essensys-hub/essensys-i2c-etoile-0v/export/n2-etoile-0v-pcb-bottom.png

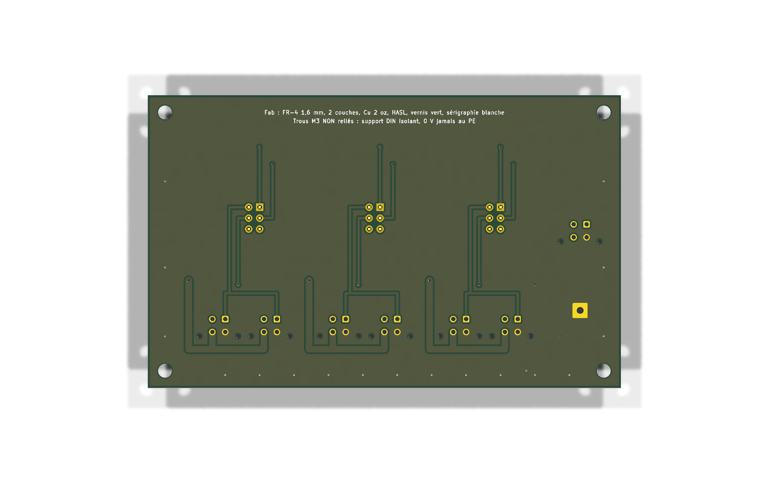
export/n2-etoile-0v-pcb-bottom.png
