essensys-hub/essensys-i2c-etoile-0v/export/n2-etoile-0v-bom.csv

Repère | Valeur | Empreinte | Fabricant | Référence | Qté
D1-D3 | SMAJ16A | Diode_SMD:D_SMA | Littelfuse | SMAJ16A | 3
F1-F3 | PTC >=30 V 1812 | Fuse:Fuse_1812_4532Metric | Littelfuse | 1812L050/30MR (à confirmer : Ihold@50°C >= 1,5 x I BA_ALIM) | 3
J1 | BP J31 (WR-MPC3 2x2) | Connector_Molex:Molex_Micro-Fit_3.0_43045-0412_2x02_P3.00mm_Vertical | Würth Elektronik | 66200421122 (WR-MPC3 2x2, vertical, THT) | 1
J2 | BA1 J1 (WR-MPC3 2x2) | Connector_Molex:Molex_Micro-Fit_3.0_43045-0412_2x02_P3.00mm_Vertical | Würth Elektronik | 66200421122 (WR-MPC3 2x2, vertical, THT) | 1
J3 | BA1 J2 (WR-MPC3 2x2) | Connector_Molex:Molex_Micro-Fit_3.0_43045-0412_2x02_P3.00mm_Vertical | Würth Elektronik | 66200421122 (WR-MPC3 2x2, vertical, THT) | 1
J4 | BA2 J1 (WR-MPC3 2x2) | Connector_Molex:Molex_Micro-Fit_3.0_43045-0412_2x02_P3.00mm_Vertical | Würth Elektronik | 66200421122 (WR-MPC3 2x2, vertical, THT) | 1
J5 | BA2 J2 (WR-MPC3 2x2) | Connector_Molex:Molex_Micro-Fit_3.0_43045-0412_2x02_P3.00mm_Vertical | Würth Elektronik | 66200421122 (WR-MPC3 2x2, vertical, THT) | 1
J6 | BA3 J1 (WR-MPC3 2x2) | Connector_Molex:Molex_Micro-Fit_3.0_43045-0412_2x02_P3.00mm_Vertical | Würth Elektronik | 66200421122 (WR-MPC3 2x2, vertical, THT) | 1
J7 | BA3 J2 (WR-MPC3 2x2) | Connector_Molex:Molex_Micro-Fit_3.0_43045-0412_2x02_P3.00mm_Vertical | Würth Elektronik | 66200421122 (WR-MPC3 2x2, vertical, THT) | 1
JP1 | Cavalier port BA1 (3 shunts) | Connector_PinHeader_2.54mm:PinHeader_2x03_P2.54mm_Vertical |  |  | 1
JP2 | Cavalier port BA2 (3 shunts) | Connector_PinHeader_2.54mm:PinHeader_2x03_P2.54mm_Vertical |  |  | 1
JP3 | Cavalier port BA3 (3 shunts) | Connector_PinHeader_2.54mm:PinHeader_2x03_P2.54mm_Vertical |  |  | 1
