essensys-hub/essensys-i2c-etoile-0v/firmware/test/traces/t04_ba3_absent_nack.csv

# 3 tentatives vers 0x13 absent (NACK adresse) | 100 ms
t_us | scl | sda
0 | 1 | 1
55 | 1 | 0
60 | 0 | 0
70 | 1 | 0
80 | 0 | 0
90 | 1 | 0
100 | 0 | 0
102 | 0 | 1
110 | 1 | 1
120 | 0 | 1
122 | 0 | 0
130 | 1 | 0
140 | 0 | 0
150 | 1 | 0
160 | 0 | 0
162 | 0 | 1
170 | 1 | 1
180 | 0 | 1
190 | 1 | 1
200 | 0 | 1
202 | 0 | 0
210 | 1 | 0
220 | 0 | 0
222 | 0 | 1
230 | 1 | 1
240 | 0 | 1
242 | 0 | 0
250 | 1 | 0
255 | 1 | 1
100260 | 1 | 0
100265 | 0 | 0
100275 | 1 | 0
100285 | 0 | 0
100295 | 1 | 0
100305 | 0 | 0
100307 | 0 | 1
100315 | 1 | 1
100325 | 0 | 1
100327 | 0 | 0
100335 | 1 | 0
100345 | 0 | 0
100355 | 1 | 0
100365 | 0 | 0
100367 | 0 | 1
100375 | 1 | 1
100385 | 0 | 1
100395 | 1 | 1
100405 | 0 | 1
100407 | 0 | 0
100415 | 1 | 0
100425 | 0 | 0
100427 | 0 | 1
100435 | 1 | 1
100445 | 0 | 1
100447 | 0 | 0
100455 | 1 | 0
100460 | 1 | 1
200465 | 1 | 0
200470 | 0 | 0
200480 | 1 | 0
200490 | 0 | 0
200500 | 1 | 0
200510 | 0 | 0
200512 | 0 | 1
200520 | 1 | 1
200530 | 0 | 1
200532 | 0 | 0
200540 | 1 | 0
200550 | 0 | 0
200560 | 1 | 0
200570 | 0 | 0
200572 | 0 | 1
200580 | 1 | 1
200590 | 0 | 1
200600 | 1 | 1
200610 | 0 | 1
200612 | 0 | 0
200620 | 1 | 0
200630 | 0 | 0
200632 | 0 | 1
200640 | 1 | 1
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
