essensys-hub/essensys-i2c-etoile-0v/firmware/test/traces/t06_response_crc_error.csv

# TPS_ACTION vers 0x12 | CRC de reponse faux
t_us | scl | sda
0 | 1 | 1
55 | 1 | 0
60 | 0 | 0
70 | 1 | 0
80 | 0 | 0
90 | 1 | 0
100 | 0 | 0
102 | 0 | 1
110 | 1 | 1
120 | 0 | 1
122 | 0 | 0
130 | 1 | 0
140 | 0 | 0
150 | 1 | 0
160 | 0 | 0
162 | 0 | 1
170 | 1 | 1
180 | 0 | 1
182 | 0 | 0
190 | 1 | 0
200 | 0 | 0
210 | 1 | 0
220 | 0 | 0
230 | 1 | 0
240 | 0 | 0
250 | 1 | 0
260 | 0 | 0
270 | 1 | 0
280 | 0 | 0
290 | 1 | 0
300 | 0 | 0
310 | 1 | 0
320 | 0 | 0
330 | 1 | 0
340 | 0 | 0
342 | 0 | 1
350 | 1 | 1
360 | 0 | 1
362 | 0 | 0
370 | 1 | 0
380 | 0 | 0
390 | 1 | 0
400 | 0 | 0
410 | 1 | 0
420 | 0 | 0
430 | 1 | 0
440 | 0 | 0
450 | 1 | 0
460 | 0 | 0
470 | 1 | 0
480 | 0 | 0
490 | 1 | 0
500 | 0 | 0
502 | 0 | 1
510 | 1 | 1
520 | 0 | 1
522 | 0 | 0
530 | 1 | 0
540 | 0 | 0
542 | 0 | 1
550 | 1 | 1
560 | 0 | 1
562 | 0 | 0
570 | 1 | 0
580 | 0 | 0
590 | 1 | 0
600 | 0 | 0
610 | 1 | 0
620 | 0 | 0
630 | 1 | 0
640 | 0 | 0
650 | 1 | 0
660 | 0 | 0
662 | 0 | 1
670 | 1 | 1
680 | 0 | 1
682 | 0 | 0
690 | 1 | 0
700 | 0 | 0
702 | 0 | 1
710 | 1 | 1
720 | 0 | 1
722 | 0 | 0
730 | 1 | 0
740 | 0 | 0
750 | 1 | 0
760 | 0 | 0
770 | 1 | 0
780 | 0 | 0
790 | 1 | 0
800 | 0 | 0
810 | 1 | 0
820 | 0 | 0
830 | 1 | 0
840 | 0 | 0
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
