essensys-hub/essensys-i2c-etoile-0v/export/n2-etoile-0v-schema.pdf

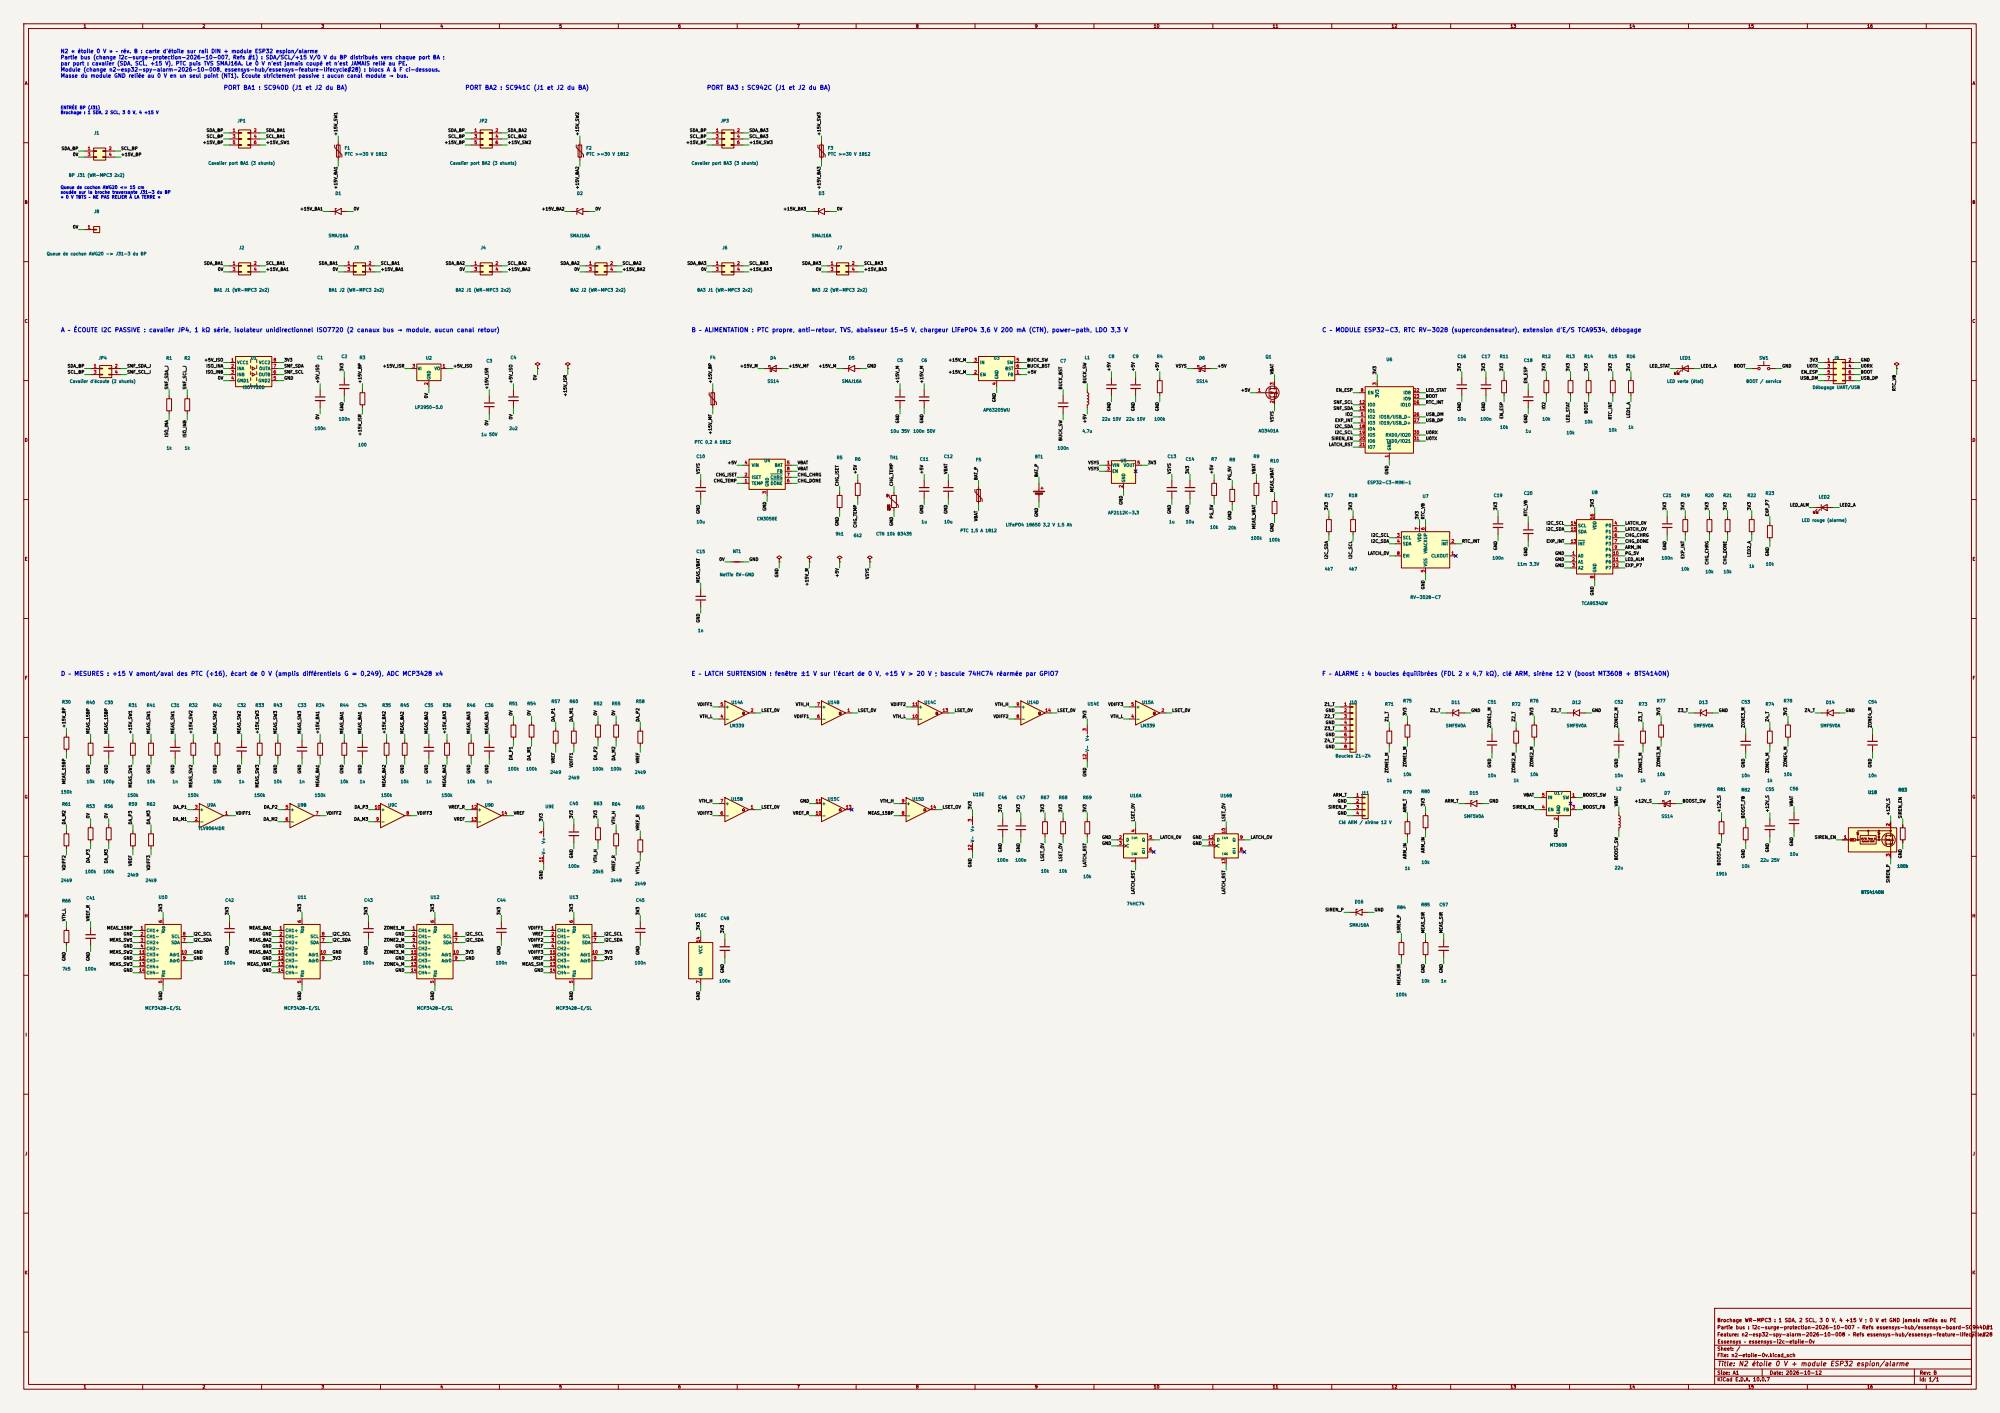
[picture p3: page 1]

N2 « étoile 0 V » – rév. B : carte d'étoile sur rail DIN + module ESP32 espion/alarme
Partie bus (change i2c-surge-protection-2026-10-007, Refs #1) : SDA/SCL/+15 V/0 V du BP distribués vers chaque port BA ; par port : cavalier (SDA, SCL, +15 V), PTC puis TVS SMAJ16A. Le 0 V n'est jamais coupé et n'est JAMAIS relié au PE.
Module (change n2-esp32-spy-alarm-2026-10-008, essensys-hub/essensys-feature-lifecycle#28) : blocs A à F ci-dessous.
Masse du module GND reliée au 0 V en un seul point (NT1). Écoute strictement passive : aucun canal module → bus.

PORT BA3 : SC942C (J1 et J2 du BA)

ENTRÉE BP (J31)
Brochage : 1 SDA, 2 SCL, 3 0 V, 4 +15 V Queue de cochon AWG20 <= 15 cm

soudée sur la broche traversante J31-3 du BP
« 0 V TBTS – NE PAS RELIER À LA TERRE »

A – ÉCOUTE I2C PASSIVE : cavalier JP4, 1 kΩ série, isolateur unidirectionnel ISO7720 (2 canaux bus → module, aucun canal retour)

C – MODULE ESP32-C3, RTC RV-3028 (supercondensateur), extension d'E/S TCA9534, débogage

F – ALARME : 4 boucles équilibrées (FDL 2 x 4,7 kΩ), clé ARM, sirène 12 V (boost MT3608 + BTS4140N)

Brochage WR-MPC3 : 1 SDA, 2 SCL, 3 0 V, 4 +15 V ; 0 V et GND jamais reliés au PE
Partie bus : i2c-surge-protection-2026-10-007 – Refs essensys-hub/essensys-board-SC944D#1
Feature: n2-esp32-spy-alarm-2026-10-008 – Refs essensys-hub/essensys-feature-lifecycle#28
Essensys – essensys-i2c-etoile-0v
Sheet: /
File: n2-etoile-0v.kicad_sch
Title: N2 étoile 0 V + module ESP32 espion/alarme

Size: A1 | Rev: B
KiCad E.D.A. 10.0.7 | Id: 1/1
