essensys-hub/essensys-i2c-etoile-0v/n2-etoile-0v.kicad_pcb

## KiCad design n2-etoile-0v.kicad_pcb (2026-10-12)

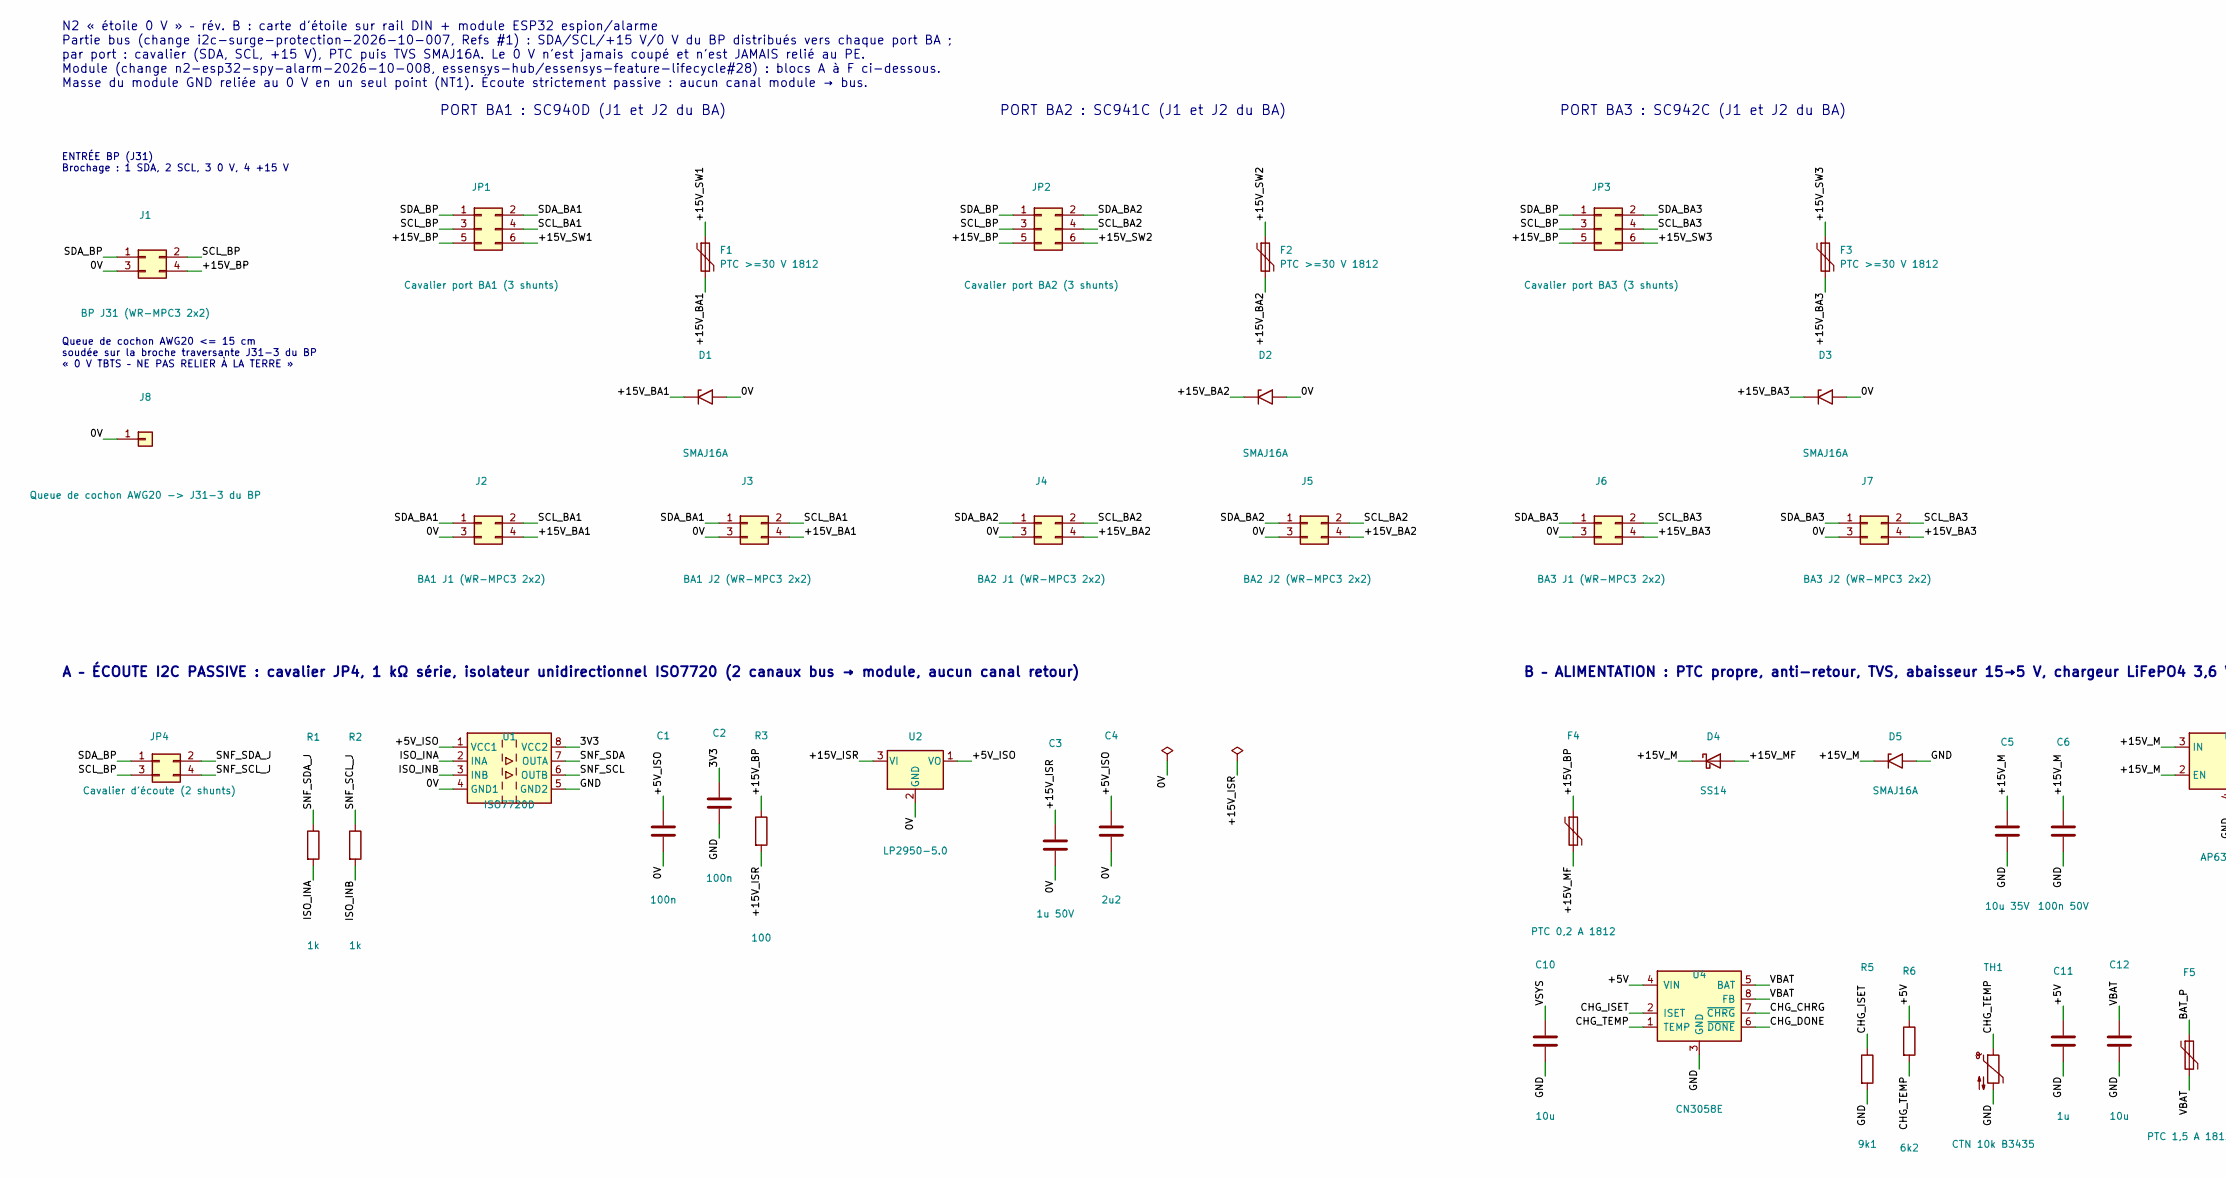
[picture p4: schematic n2-etoile-0v.kicad_sch, N2 étoile 0 V + module ESP32 espion/alarme, part in row 1, column 1]

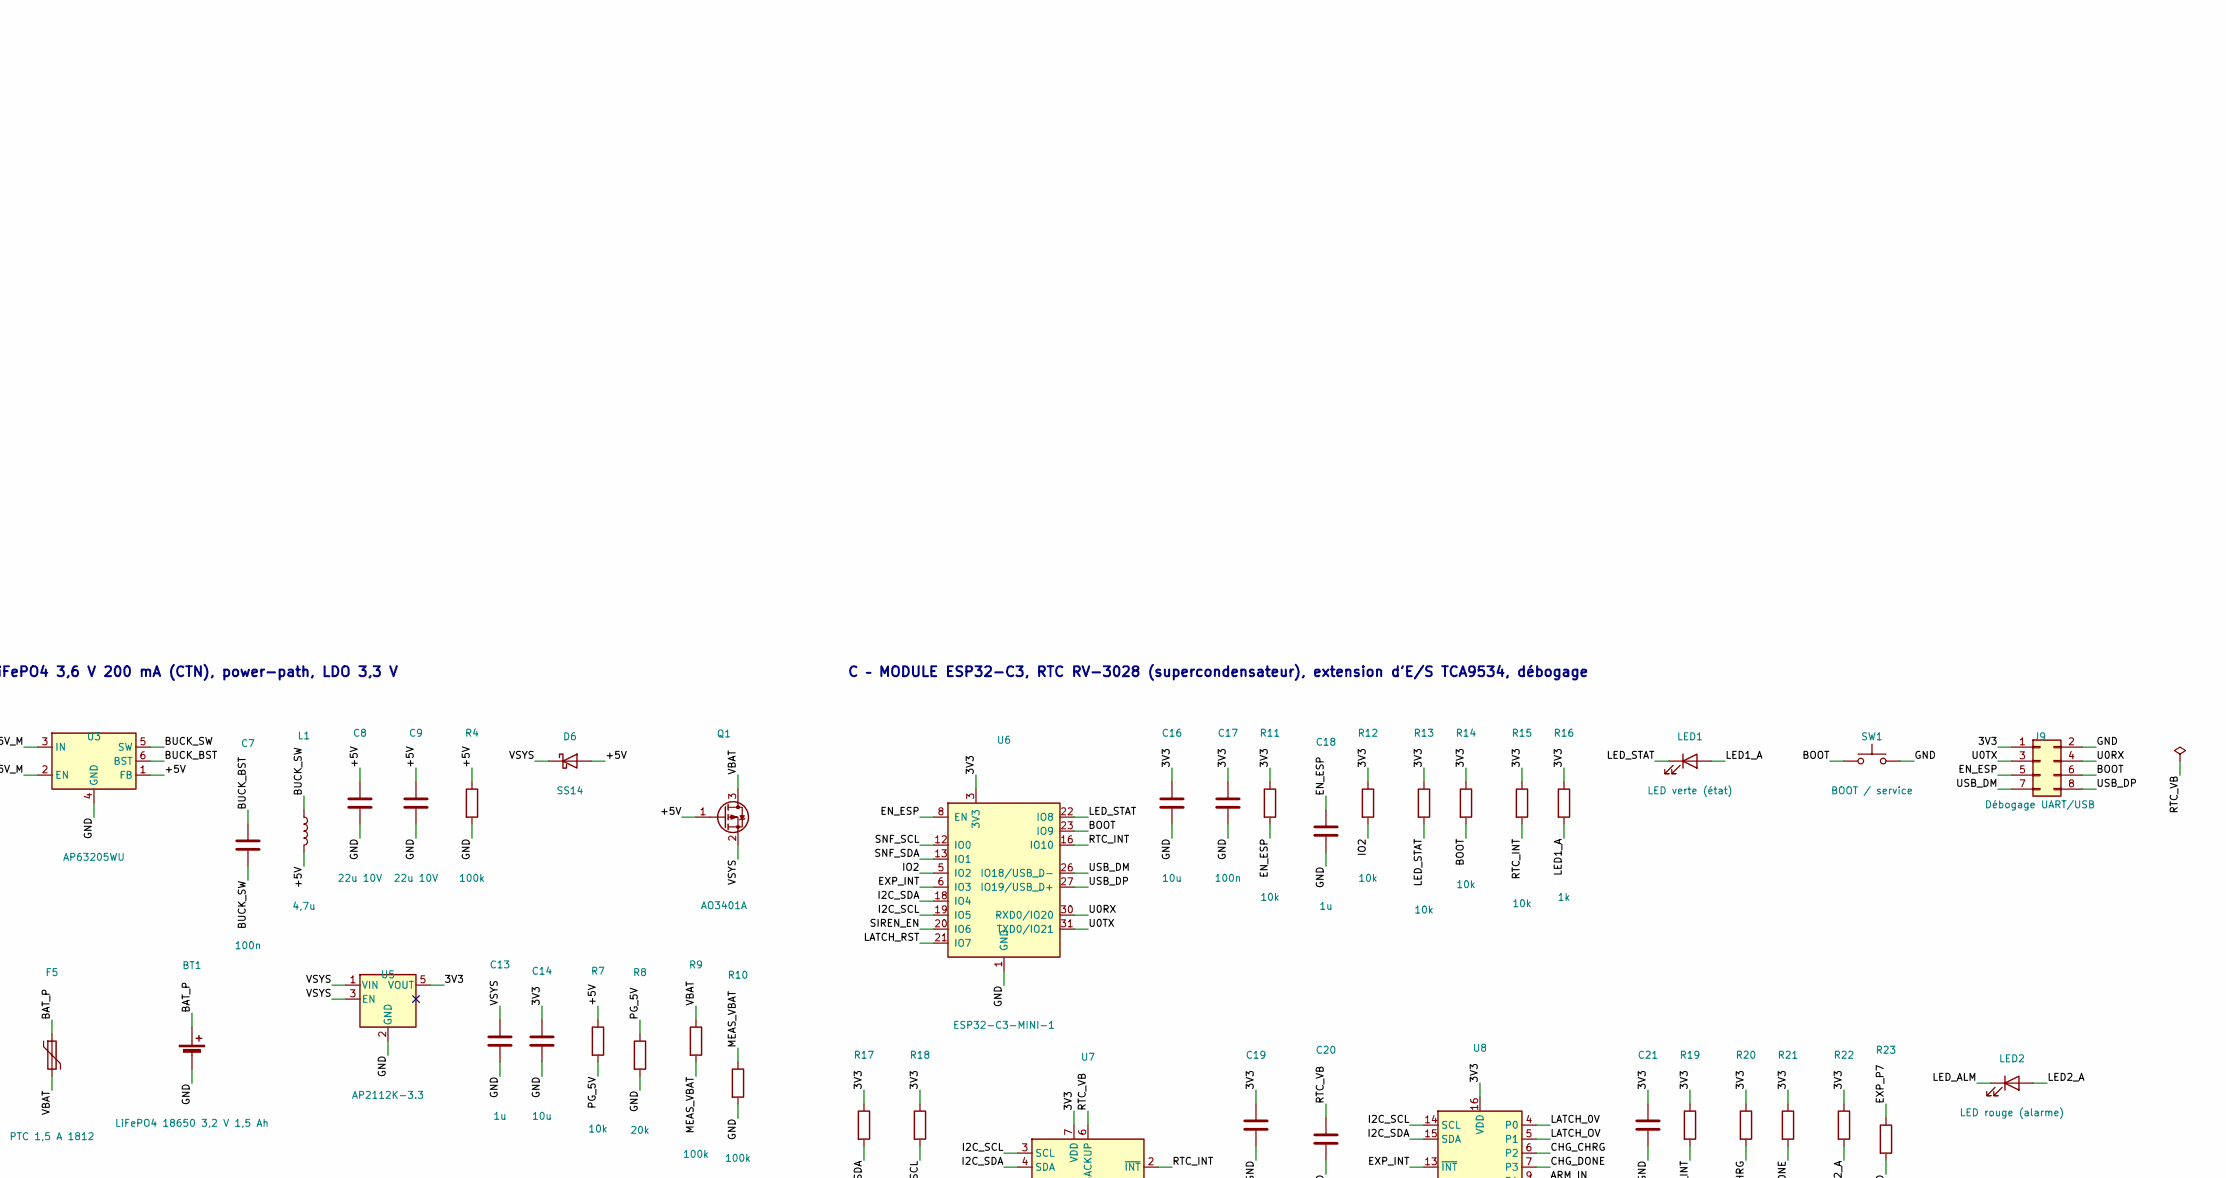
[picture p5: schematic n2-etoile-0v.kicad_sch, N2 étoile 0 V + module ESP32 espion/alarme, part in row 1, column 2]

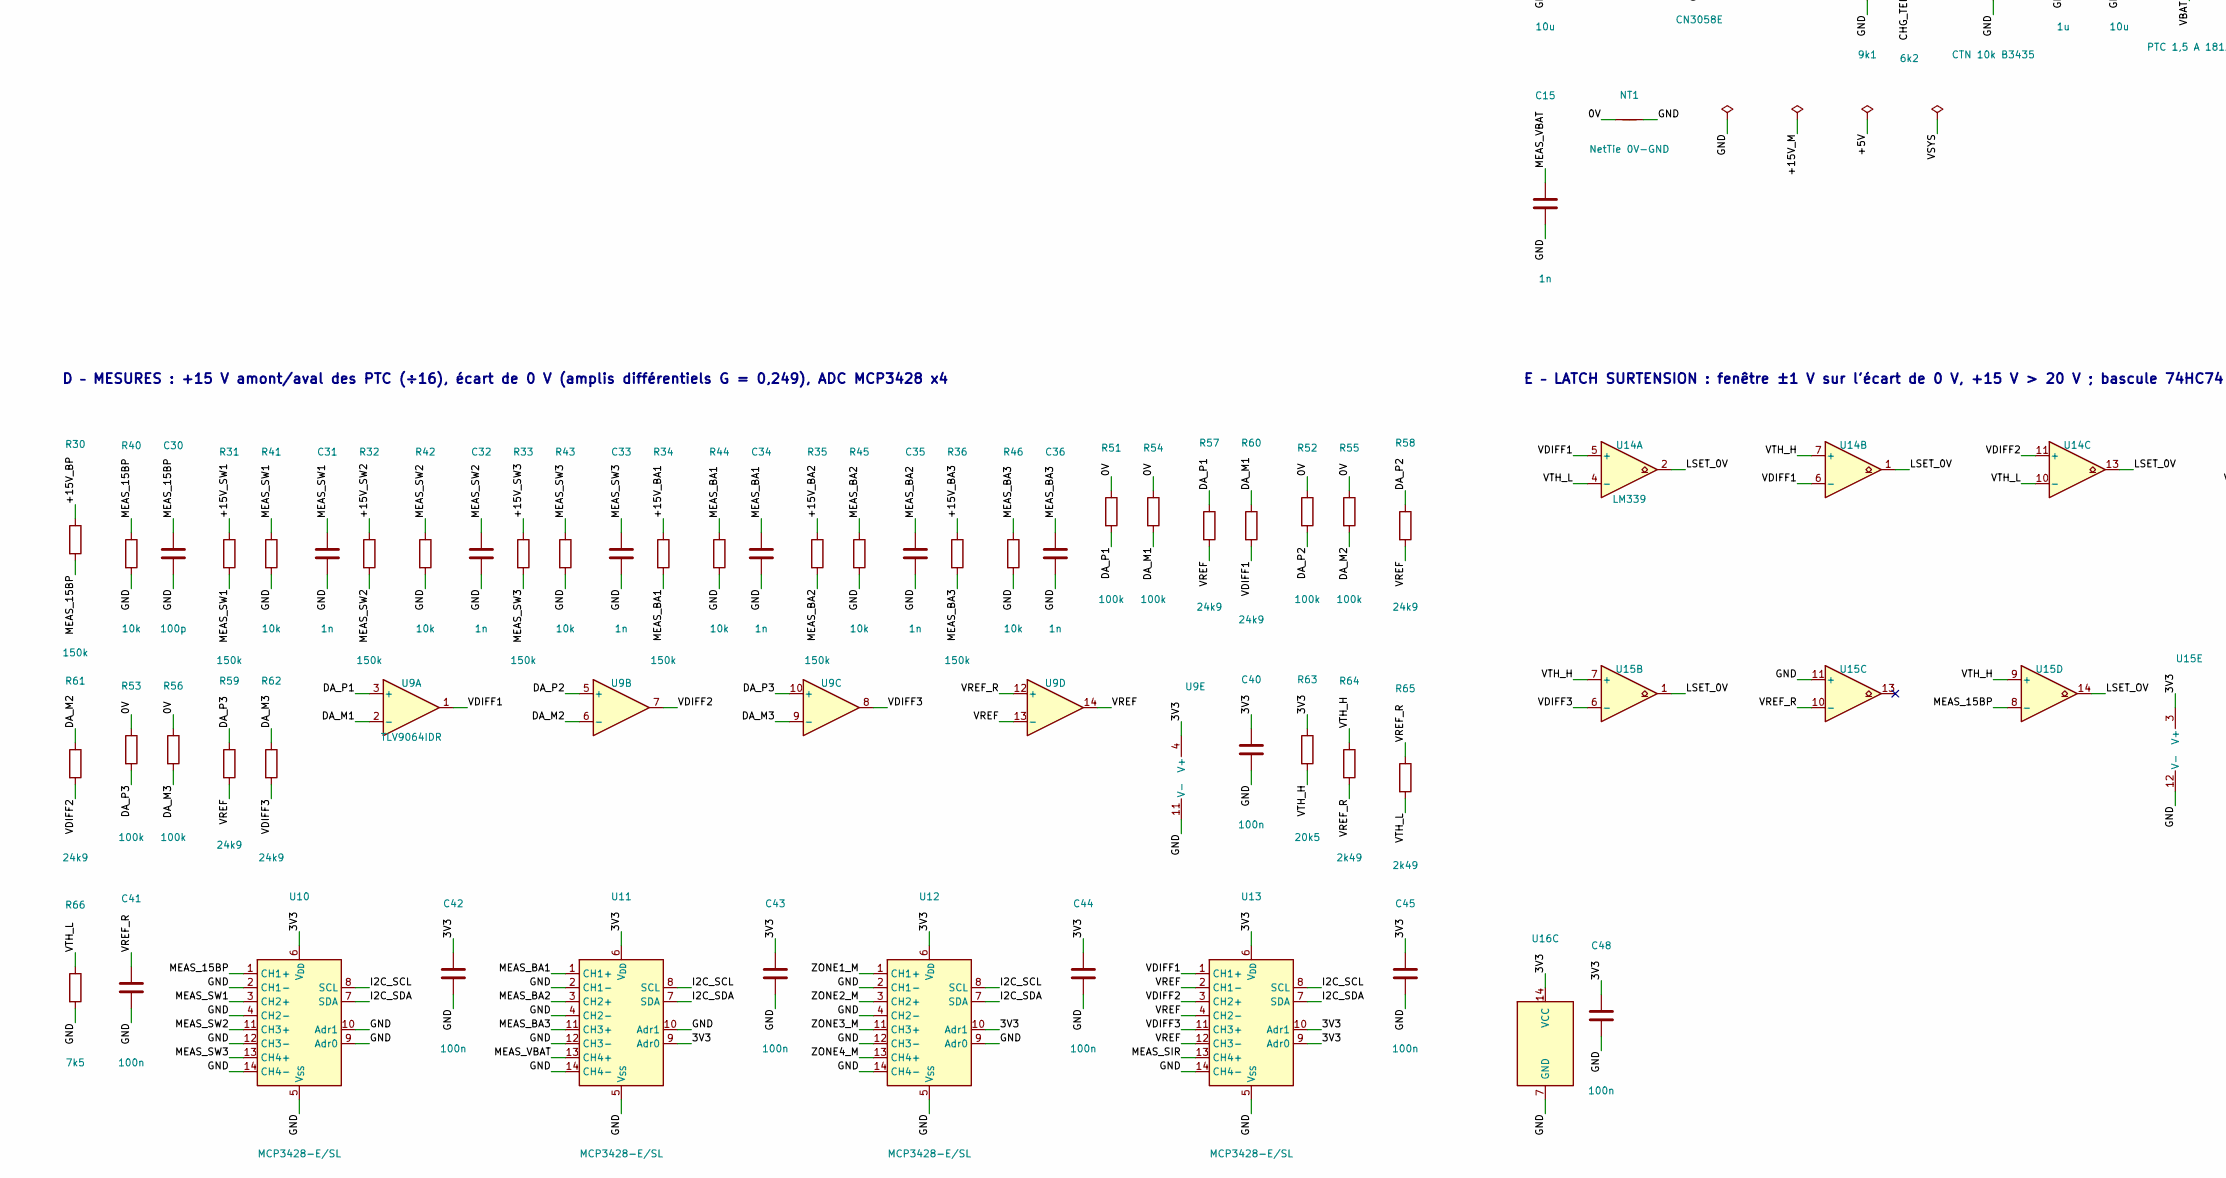
[picture p6: schematic n2-etoile-0v.kicad_sch, N2 étoile 0 V + module ESP32 espion/alarme, part in row 2, column 1]

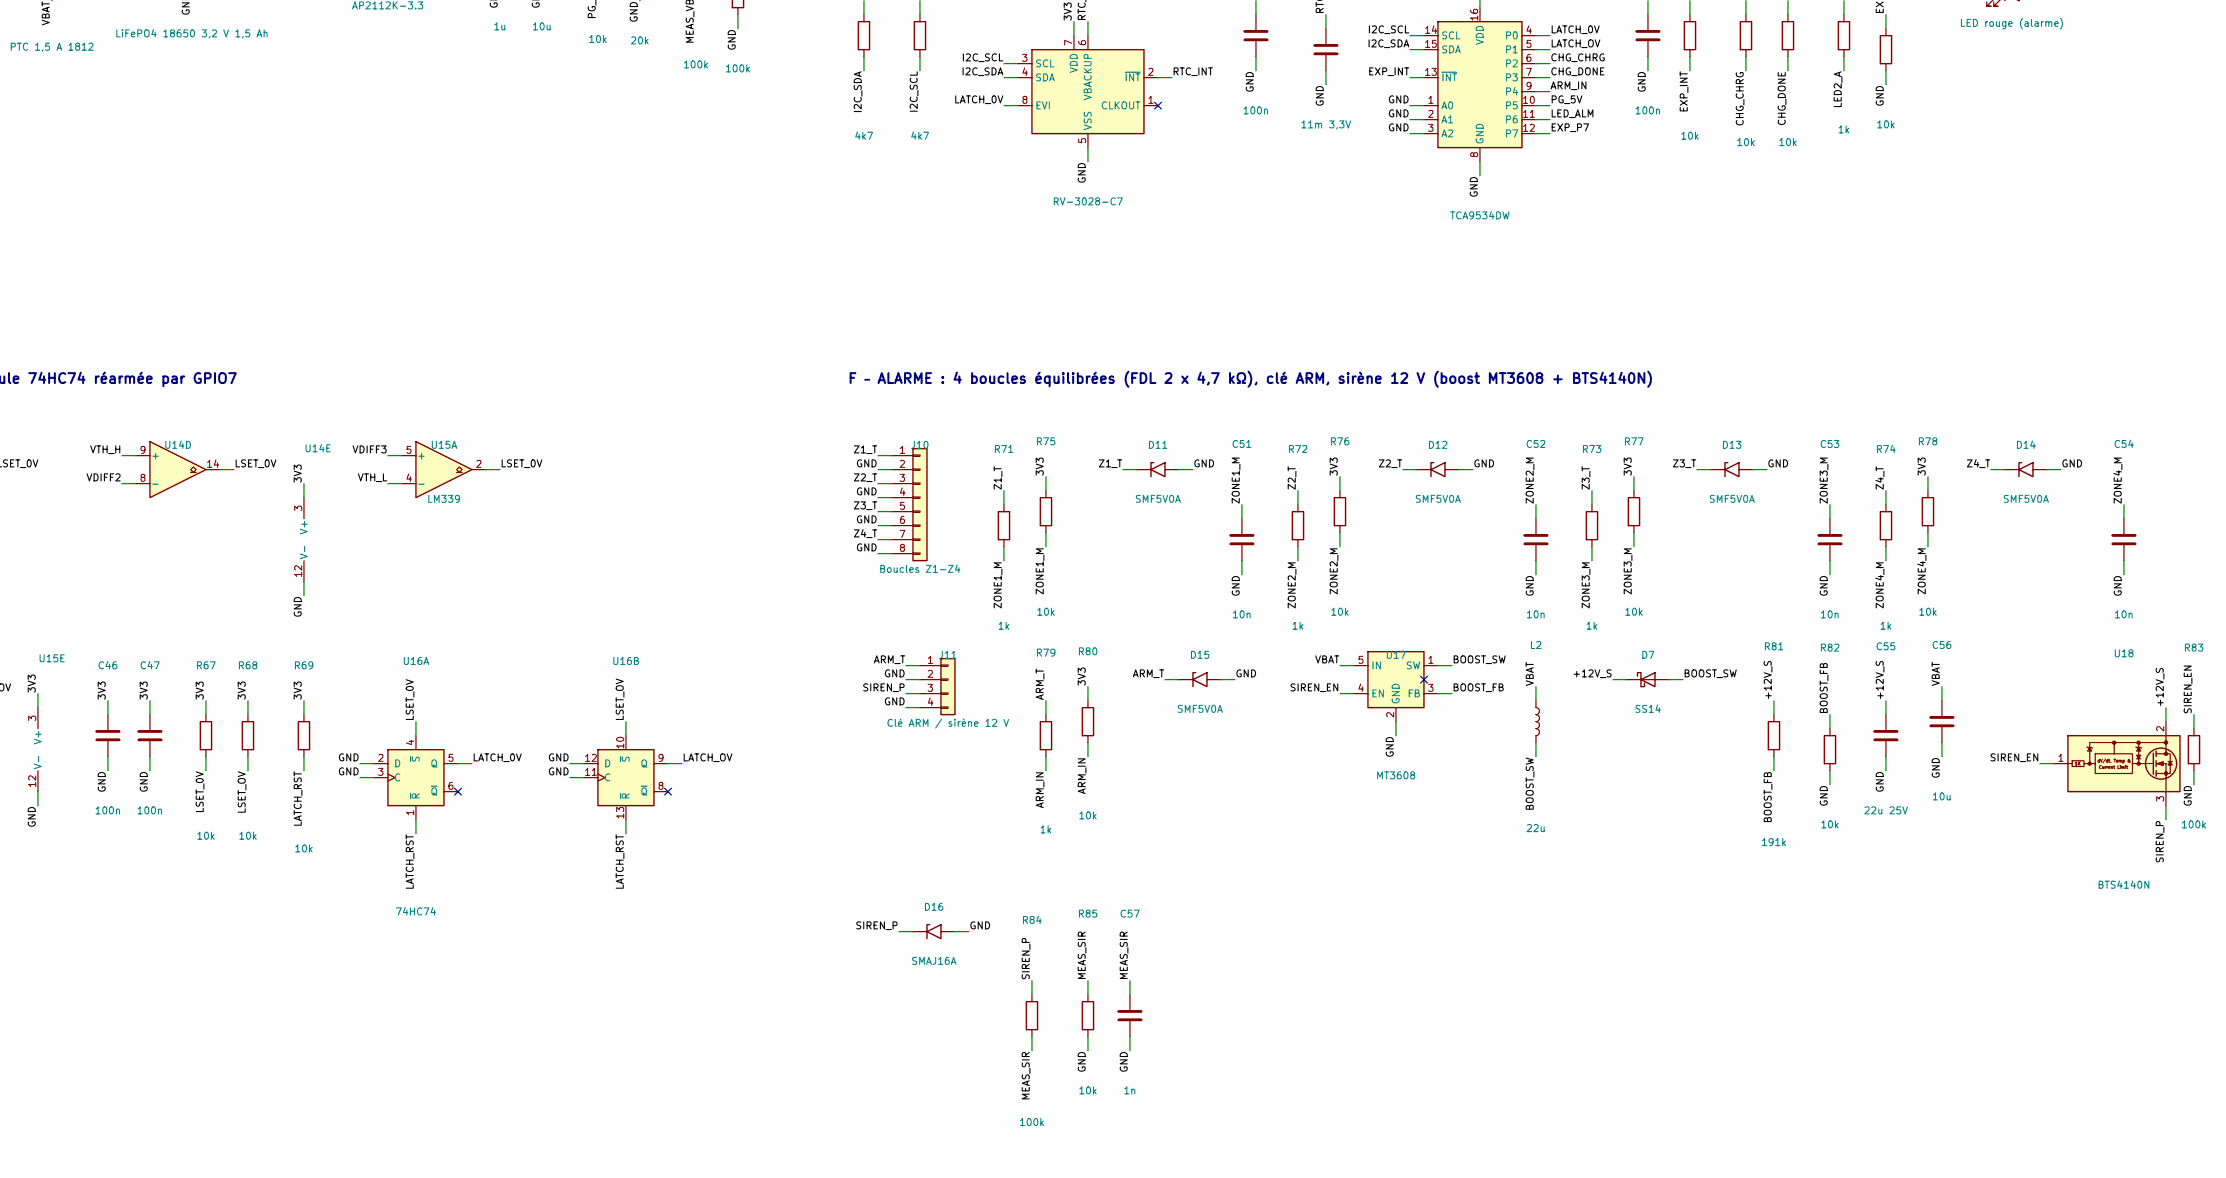
[picture p7: schematic n2-etoile-0v.kicad_sch, N2 étoile 0 V + module ESP32 espion/alarme, part in row 2, column 2]

Parts:
BT1: LiFePO4 18650 3,2 V 1,5 Ah; BatteryHolder_Keystone_1042_1x18650; MPN 1042 (porte-pile 18650) + cellule IFR18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
C1, C2, C7, C17, C19, C21, C40, C41, C42, C43, C44, C45, C46, C47, C48: 100n; C_0603_1608Metric
C3: 1u 50V; C_0805_2012Metric
C4: 2u2; C_0603_1608Metric
C5: 10u 35V; C_1206_3216Metric
C6: 100n 50V; C_0603_1608Metric
C8, C9: 22u 10V; C_1206_3216Metric
C10, C12, C14, C16, C56: 10u; C_0805_2012Metric
C11, C13, C18: 1u; C_0603_1608Metric
C15, C31, C32, C33, C34, C35, C36, C57: 1n; C_0603_1608Metric
C20: 11m 3,3V; C_1210_3225Metric; MPN CPH3225A (supercondensateur, chargé par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
C30: 100p; C_0603_1608Metric
C51, C52, C53, C54: 10n; C_0603_1608Metric
C55: 22u 25V; C_1206_3216Metric
D1, D2, D3, D5, D16: SMAJ16A; D_SMA; MPN SMAJ16A
D4, D6, D7: SS14; D_SMA
D11, D12, D13, D14, D15: SMF5V0A; D_SMF; MPN SMF5.0A
F1, F2, F3: PTC >=30 V 1812; Fuse_1812_4532Metric; MPN 1812L050/30MR (à confirmer : Ihold@50°C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
F4: PTC 0,2 A 1812; Fuse_1812_4532Metric; MPN MF-MSMF020-2 (Ihold 0,2 A, 30 V, à conf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
F5: PTC 1,5 A 1812; Fuse_1812_4532Metric; MPN 1812L150/12MR (à confirmer)
J1: BP J31 (WR-MPC3 2x2); Molex_Micro-Fit_3.0_43045-0412_2x02_P3.00mm_Vertical; MPN 66200421122 (WR-MPC3 2x2, vertical, THT)
J2: BA1 J1 (WR-MPC3 2x2); Molex_Micro-Fit_3.0_43045-0412_2x02_P3.00mm_Vertical; MPN 66200421122 (WR-MPC3 2x2, vertical, THT)
J3: BA1 J2 (WR-MPC3 2x2); Molex_Micro-Fit_3.0_43045-0412_2x02_P3.00mm_Vertical; MPN 66200421122 (WR-MPC3 2x2, vertical, THT)
J4: BA2 J1 (WR-MPC3 2x2); Molex_Micro-Fit_3.0_43045-0412_2x02_P3.00mm_Vertical; MPN 66200421122 (WR-MPC3 2x2, vertical, THT)
J5: BA2 J2 (WR-MPC3 2x2); Molex_Micro-Fit_3.0_43045-0412_2x02_P3.00mm_Vertical; MPN 66200421122 (WR-MPC3 2x2, vertical, THT)
J6: BA3 J1 (WR-MPC3 2x2); Molex_Micro-Fit_3.0_43045-0412_2x02_P3.00mm_Vertical; MPN 66200421122 (WR-MPC3 2x2, vertical, THT)
J7: BA3 J2 (WR-MPC3 2x2); Molex_Micro-Fit_3.0_43045-0412_2x02_P3.00mm_Vertical; MPN 66200421122 (WR-MPC3 2x2, vertical, THT)
J8: Queue de cochon AWG20 -> J31-3 du BP; SolderWire-0.75sqmm_1x01_D1.25mm_OD3.5mm
J9: Débogage UART/USB; PinHeader_2x04_P2.54mm_Vertical
J10: Boucles Z1-Z4; TerminalBlock_Phoenix_PT-1,5-8-3.5-H_1x08_P3.50mm_Horizontal; MPN 1984688 (PT 1,5/8-3,5-H)
J11: Clé ARM / sirène 12 V; TerminalBlock_Phoenix_PT-1,5-4-3.5-H_1x04_P3.50mm_Horizontal; MPN 1984633 (PT 1,5/4-3,5-H)
JP1: Cavalier port BA1 (3 shunts); PinHeader_2x03_P2.54mm_Vertical
JP2: Cavalier port BA2 (3 shunts); PinHeader_2x03_P2.54mm_Vertical
JP3: Cavalier port BA3 (3 shunts); PinHeader_2x03_P2.54mm_Vertical
JP4: Cavalier d'écoute (2 shunts); PinHeader_2x02_P2.54mm_Vertical
L1: 4,7u; L_Taiyo-Yuden_NR-40xx; MPN NR4018T4R7M
L2: 22u; L_Taiyo-Yuden_NR-50xx; MPN NR5040T220M
LED1: LED verte (état); LED_0603_1608Metric
LED2: LED rouge (alarme); LED_0603_1608Metric
NT1: NetTie 0V-GND; NetTie-2_SMD_Pad2.0mm
Q1: AO3401A; SOT-23
R1, R2, R16, R22: 1k; R_0603_1608Metric
R3: 100; R_1206_3216Metric
R4, R83: 100k; R_0603_1608Metric
R5: 9k1; R_0603_1608Metric
R6: 6k2; R_0603_1608Metric
R7, R11, R12, R13, R14, R15, R19, R20, R21, R23, R67, R68, R69, R75, R76, R77, R78, R80, R82: 10k; R_0603_1608Metric
R8: 20k; R_0603_1608Metric
R9, R10, R84: 100k; R_0603_1608Metric; Tolerance 0,1 % 25 ppm/°C
R17, R18: 4k7; R_0603_1608Metric
R30, R31, R32, R33, R34, R35, R36: 150k; R_0805_2012Metric; Tolerance 0,1 % 25 ppm/°C
R40, R41, R42, R43, R44, R45, R46, R85: 10k; R_0603_1608Metric; Tolerance 0,1 % 25 ppm/°C
R51, R52, R53, R54, R55, R56: 100k; R_1206_3216Metric; Tolerance 0,1 % 25 ppm/°C
R57, R58, R59, R60, R61, R62: 24k9; R_0603_1608Metric; Tolerance 0,1 % 25 ppm/°C
R63: 20k5; R_0603_1608Metric; Tolerance 0,1 % 25 ppm/°C
R64, R65: 2k49; R_0603_1608Metric; Tolerance 0,1 % 25 ppm/°C
R66: 7k5; R_0603_1608Metric; Tolerance 0,1 % 25 ppm/°C
R71, R72, R73, R74, R79: 1k; R_0805_2012Metric
R81: 191k; R_0603_1608Metric
SW1: BOOT / service; SW_SPST_PTS645Sx43SMTR92
TH1: CTN 10k B3435; R_0603_1608Metric; MPN NCP18XH103F03RB (au contact du porte-pi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
U1: ISO7720D; SOIC-8_3.9x4.9mm_P1.27mm; MPN ISO7720DR (2/0 canaux ; seconde source 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
U2: LP2950-5.0; TO-92_Inline; MPN LP2950-50LPRE3 (VIN max 30 V)
U3: AP63205WU; TSOT-23-6; MPN AP63205WU-7 (5 V fixe, 3,8-32 V)
U4: CN3058E; SOIC-8-1EP_3.9x4.9mm_P1.27mm_EP2.41x3.3mm; MPN CN3058E (LiFePO4 3,6 V ; brochage à vér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
U5: AP2112K-3.3; SOT-23-5; MPN AP2112K-3.3TRG1
U6: ESP32-C3-MINI-1; ESP32-C6-MINI-1; MPN ESP32-C3-MINI-1-N4 (empreinte = motif M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
U7: RV-3028-C7; MicroCrystal_C7_SON-8_1.5x3.2mm_P0.9mm; MPN RV-3028-C7 32.768kHz 1ppm-TA-QC (I2C 0x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
U8: TCA9534DW; SOIC-16W_7.5x10.3mm_P1.27mm; MPN TCA9534DWR (I2C 0x20)
U9: TLV9064IDR; SOIC-14_3.9x8.7mm_P1.27mm; MPN TLV9064IDR (10 MHz, RRIO)
U10, U11, U12, U13: MCP3428-E/SL; SOIC-14_3.9x8.7mm_P1.27mm; MPN MCP3428-E/SL (16 bits, réf. 2,048 V ; A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
U14: LM339; SOIC-14_3.9x8.7mm_P1.27mm; MPN LM339DR
U15: LM339; SOIC-14_3.9x8.7mm_P1.27mm; MPN LM339DR (U15D inutilisé)
U16: 74HC74; SOIC-14_3.9x8.7mm_P1.27mm; MPN 74HC74D
U17: MT3608; SOT-23-6; MPN MT3608 (12 V depuis VBAT, actif seuleme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
U18: BTS4140N; SOT-223; MPN BTS4140N (high-side protégé : limitatio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

Connections:
/0V: C1.2, C3.2, C4.2, D1.2 (A2), D2.2 (A2), D3.2 (A2), J1.3, J2.3, J3.3, J4.3, J5.3, J6.3, J7.3, J8.1, NT1.1, R51.1, R52.1, R53.1, R54.1, R55.1, R56.1, U1.4 (GND1), U2.2 (GND)
/3V3: C2.1, C14.1, C16.1, C17.1, C19.1, C21.1, C40.1, C42.1, C43.1, C44.1, C45.1, C46.1, C47.1, C48.1, J9.1, R11.1, R12.1, R13.1, R14.1, R15.1, R16.1, R17.1, R18.1, R19.1, R20.1, R21.1, R22.1, R63.1, R67.1, R68.1, R69.1, R75.1, R76.1, R77.1, R78.1, R80.1, U1.8 (VCC2), U5.5 (VOUT), U6.3 (3V3), U7.7 (VDD), U8.16 (VDD), U9.4 (V+), U10.6 (V_{DD}), U11.6 (V_{DD}), U11.9 (Adr0), U12.6 (V_{DD}), U12.10 (Adr1), U13.6 (V_{DD}), U13.9 (Adr0), U13.10 (Adr1), U14.3 (V+), U15.3 (V+), U16.14 (VCC)
/+5V: C8.1, C9.1, C11.1, D6.2 (A), L1.2, Q1.1 (G), R4.1, R6.1, R7.1, U3.1 (FB), U4.4 (VIN)
/+5V_ISO: C1.1, C4.1, U1.1 (VCC1), U2.1 (VO)
/+12V_S: C55.1, D7.1 (K), R81.1, U18.2 (V_{bb}), U18.4 (V_{bb})
/+15V_BA1: D1.1 (A1), F1.2, J2.4, J3.4, R34.1
/+15V_BA2: D2.1 (A1), F2.2, J4.4, J5.4, R35.1
/+15V_BA3: D3.1 (A1), F3.2, J6.4, J7.4, R36.1
/+15V_BP: F4.1, J1.4, JP1.5, JP2.5, JP3.5, R3.1, R30.1
/+15V_ISR: C3.1, R3.2, U2.3 (VI)
/+15V_M: C5.1, C6.1, D4.1 (K), D5.1 (A1), U3.2 (EN), U3.3 (IN)
/+15V_MF: D4.2 (A), F4.2
/+15V_SW1: F1.1, JP1.6, R31.1
/+15V_SW2: F2.1, JP2.6, R32.1
/+15V_SW3: F3.1, JP3.6, R33.1
/ARM_IN: R79.2, R80.2, U8.9 (P4)
/ARM_T: D15.1 (A1), J11.1, R79.1
/BAT_P: BT1.1 (+), F5.1
/BOOST_FB: R81.2, R82.1, U17.3 (FB)
/BOOST_SW: D7.2 (A), L2.2, U17.1 (SW)
/BOOT: J9.6, R14.2, SW1.1, U6.23 (IO9)
/BUCK_BST: C7.1, U3.6 (BST)
/BUCK_SW: C7.2, L1.1, U3.5 (SW)
/CHG_CHRG: R20.2, U4.7 (~CHRG), U8.6 (P2)
/CHG_DONE: R21.2, U4.6 (~DONE), U8.7 (P3)
/CHG_ISET: R5.1, U4.2 (ISET)
/CHG_TEMP: R6.2, TH1.1, U4.1 (TEMP)
/DA_M1: R54.2, R60.1, U9.2 (-)
/DA_M2: R55.2, R61.1, U9.6 (-)
/DA_M3: R56.2, R62.1, U9.9 (-)
/DA_P1: R51.2, R57.1, U9.3 (+)
/DA_P2: R52.2, R58.1, U9.5 (+)
/DA_P3: R53.2, R59.1, U9.10 (+)
/EN_ESP: C18.1, J9.5, R11.2, U6.8 (EN)
/EXP_INT: R19.2, U6.6 (IO3), U8.13 (~INT)
/EXP_P7: R23.1, U8.12 (P7)
/GND: BT1.2 (-), C2.2, C5.2, C6.2, C8.2, C9.2, C10.2, C11.2, C12.2, C13.2, C14.2, C15.2, C16.2, C17.2, C18.2, C19.2, C20.2, C21.2, C30.2, C31.2, C32.2, C33.2, C34.2, C35.2, C36.2, C40.2, C41.2, C42.2, C43.2, C44.2, C45.2, C46.2, C47.2, C48.2, C51.2, C52.2, C53.2, C54.2, C55.2, C56.2, C57.2, D5.2 (A2), D11.2 (A2), D12.2 (A2), D13.2 (A2), D14.2 (A2), D15.2 (A2), D16.2 (A2), J9.2, J10.2, J10.4, J10.6, J10.8, J11.2, J11.4, NT1.2, R4.2, R5.2, R8.2, R10.2, R23.2, R40.2, R41.2, R42.2, R43.2, R44.2, R45.2, R46.2, R66.2, R82.2, R83.2, R85.2, SW1.2, TH1.2, U1.5 (GND2), U3.4 (GND), U4.3 (GND), U4.9 (GND), U5.2 (GND), U6.1 (GND), U6.2 (GND), U6.11 (GND), U6.14 (GND), U6.36 (GND), U6.37 (GND), U6.38 (GND), U6.39 (GND), U6.40 (GND), U6.41 (GND), U6.42 (GND), U6.43 (GND), U6.44 (GND), U6.45 (GND), U6.46 (GND), U6.47 (GND), U6.48 (GND), U6.49 (GND), U6.50 (GND), U6.51 (GND), U6.52 (GND), U6.53 (GND), U7.5 (VSS), U8.1 (A0), U8.2 (A1), U8.3 (A2), U8.8 (GND), U9.11 (V-), U10.2 (CH1-), U10.4 (CH2-), U10.5 (V_{SS}), U10.9 (Adr0), U10.10 (Adr1), U10.12 (CH3-), U10.14 (CH4-), U11.2 (CH1-), U11.4 (CH2-), U11.5 (V_{SS}), U11.10 (Adr1), U11.12 (CH3-), U11.14 (CH4-), U12.2 (CH1-), U12.4 (CH2-), U12.5 (V_{SS}), U12.9 (Adr0), U12.12 (CH3-), U12.14 (CH4-), U13.5 (V_{SS}), U13.14 (CH4-), U14.12 (V-), U15.11 (+), U15.12 (V-), U16.2 (D), U16.3 (C), U16.7 (GND), U16.11 (C), U16.12 (D), U17.2 (GND)
/I2C_SCL: R18.2, U6.19 (IO5), U7.3 (SCL), U8.14 (SCL), U10.8 (SCL), U11.8 (SCL), U12.8 (SCL), U13.8 (SCL)
/I2C_SDA: R17.2, U6.18 (IO4), U7.4 (SDA), U8.15 (SDA), U10.7 (SDA), U11.7 (SDA), U12.7 (SDA), U13.7 (SDA)
/IO2: R12.2, U6.5 (IO2)
/ISO_INA: R1.2, U1.2 (INA)
/ISO_INB: R2.2, U1.3 (INB)
/LATCH_0V: U7.8 (EVI), U8.4 (P0), U16.5 (Q)
/LATCH_OV: U8.5 (P1), U16.9 (Q)
/LATCH_RST: R69.2, U6.21 (IO7), U16.1 (~R), U16.13 (~R)
/LED1_A: LED1.2 (A), R16.2
/LED2_A: LED2.2 (A), R22.2
/LED_ALM: LED2.1 (K), U8.11 (P6)
/LED_STAT: LED1.1 (K), R13.2, U6.22 (IO8)
/LSET_0V: R67.2, U14.1, U14.2, U14.13, U14.14, U15.1, U15.2, U16.4 (~S)
/LSET_OV: R68.2, U15.14, U16.10 (~S)
/MEAS_15BP: C30.1, R30.2, R40.1, U10.1 (CH1+), U15.8 (-)
/MEAS_BA1: C34.1, R34.2, R44.1, U11.1 (CH1+)
/MEAS_BA2: C35.1, R35.2, R45.1, U11.3 (CH2+)
/MEAS_BA3: C36.1, R36.2, R46.1, U11.11 (CH3+)
/MEAS_SIR: C57.1, R84.2, R85.1, U13.13 (CH4+)
/MEAS_SW1: C31.1, R31.2, R41.1, U10.3 (CH2+)
/MEAS_SW2: C32.1, R32.2, R42.1, U10.11 (CH3+)
/MEAS_SW3: C33.1, R33.2, R43.1, U10.13 (CH4+)
/MEAS_VBAT: C15.1, R9.2, R10.1, U11.13 (CH4+)
/PG_5V: R7.2, R8.1, U8.10 (P5)
/RTC_INT: R15.2, U6.16 (IO10), U7.2 (~INT)
/RTC_VB: C20.1, U7.6 (VBACKUP)
/SCL_BA1: J2.2, J3.2, JP1.4
/SCL_BA2: J4.2, J5.2, JP2.4
/SCL_BA3: J6.2, J7.2, JP3.4
/SCL_BP: J1.2, JP1.3, JP2.3, JP3.3, JP4.3
/SDA_BA1: J2.1, J3.1, JP1.2
/SDA_BA2: J4.1, J5.1, JP2.2
/SDA_BA3: J6.1, J7.1, JP3.2
/SDA_BP: J1.1, JP1.1, JP2.1, JP3.1, JP4.1
/SIREN_EN: R83.1, U6.20 (IO6), U17.4 (EN), U18.1 (IN)
/SIREN_P: D16.1 (A1), J11.3, R84.1, U18.3 (OUT)
/SNF_SCL: U1.6 (OUTB), U6.12 (IO0)
/SNF_SCL_J: JP4.4, R2.1
/SNF_SDA: U1.7 (OUTA), U6.13 (IO1)
/SNF_SDA_J: JP4.2, R1.1
/U0RX: J9.4, U6.30 (RXD0/IO20)
/U0TX: J9.3, U6.31 (TXD0/IO21)
/USB_DM: J9.7, U6.26 (IO18/USB_D-)
/USB_DP: J9.8, U6.27 (IO19/USB_D+)
/VBAT: C12.1, C56.1, F5.2, L2.1, Q1.3 (D), R9.1, U4.5 (BAT), U4.8 (FB), U17.5 (IN)
/VDIFF1: R60.2, U9.1, U13.1 (CH1+), U14.5 (+), U14.6 (-)
/VDIFF2: R61.2, U9.7, U13.3 (CH2+), U14.8 (-), U14.11 (+)
/VDIFF3: R62.2, U9.8, U13.11 (CH3+), U15.5 (+), U15.6 (-)
/VREF: R57.2, R58.2, R59.2, U9.13 (-), U9.14, U13.2 (CH1-), U13.4 (CH2-), U13.12 (CH3-)
/VREF_R: C41.1, R64.2, R65.1, U9.12 (+), U15.10 (-)
/VSYS: C10.1, C13.1, D6.1 (K), Q1.2 (S), U5.1 (VIN), U5.3 (EN)
/VTH_H: R63.2, R64.1, U14.7 (+), U14.9 (+), U15.7 (+), U15.9 (+)
/VTH_L: R65.2, R66.1, U14.4 (-), U14.10 (-), U15.4 (-)
/Z1_T: D11.1 (A1), J10.1, R71.1
/Z2_T: D12.1 (A1), J10.3, R72.1
/Z3_T: D13.1 (A1), J10.5, R73.1
/Z4_T: D14.1 (A1), J10.7, R74.1
/ZONE1_M: C51.1, R71.2, R75.2, U12.1 (CH1+)
/ZONE2_M: C52.1, R72.2, R76.2, U12.3 (CH2+)
/ZONE3_M: C53.1, R73.2, R77.2, U12.11 (CH3+)
/ZONE4_M: C54.1, R74.2, R78.2, U12.13 (CH4+)

Notes on the sheet:
ENTRÉE BP (J31) Brochage : 1 SDA, 2 SCL, 3 0 V, 4 +15 V
Queue de cochon AWG20 <= 15 cm soudée sur la broche traversante J31-3 du BP « 0 V TBTS – NE PAS RELIER À LA TERRE »
PORT BA1 : SC940D (J1 et J2 du BA)
PORT BA2 : SC941C (J1 et J2 du BA)
PORT BA3 : SC942C (J1 et J2 du BA)
N2 « étoile 0 V » – rév. B : carte d'étoile sur rail DIN + module ESP32 espion/alarme Partie bus (change i2c-surge-protection-2026-10-007, Refs #1) : SDA/SCL/+15 V/0 V du BP distribués vers chaque port BA ; par port : cavalier (SDA, SCL, +15 V), PTC puis TVS SMAJ16A. Le 0 V n'est jamais coupé et n'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
A – ÉCOUTE I2C PASSIVE : cavalier JP4, 1 kΩ série, isolateur unidirectionnel ISO7720 (2 canaux bus → module, aucun canal retour)
B – ALIMENTATION : PTC propre, anti-retour, TVS, abaisseur 15→5 V, chargeur LiFePO4 3,6 V 200 mA (CTN), power-path, LDO 3,3 V
C – MODULE ESP32-C3, RTC RV-3028 (supercondensateur), extension d'E/S TCA9534, débogage
D – MESURES : +15 V amont/aval des PTC (÷16), écart de 0 V (amplis différentiels G = 0,249), ADC MCP3428 x4
E – LATCH SURTENSION : fenêtre ±1 V sur l'écart de 0 V, +15 V > 20 V ; bascule 74HC74 réarmée par GPIO7
F – ALARME : 4 boucles équilibrées (FDL 2 x 4,7 kΩ), clé ARM, sirène 12 V (boost MT3608 + BTS4140N)

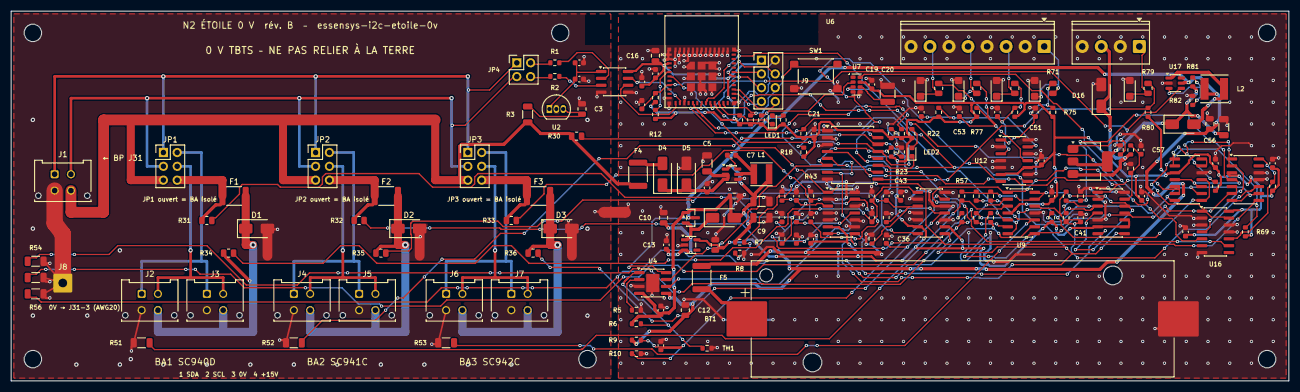
[picture p8: board n2-etoile-0v.kicad_pcb from above]

Board: 2 copper layers, 235.0 x 68.0 mm, 181 parts (0 on the bottom side), 98 nets.

Other parts of the board:
H1, H2, H3, H4, H5, H6: M3 isolé; MountingHole_3.2mm_M3
