essensys-hub/essensys-i2c-etoile-0v/firmware/components/n2_core/src/n2_sha256.c

#include "n2_sha256.h"

#include <string.h>

static const uint32_t K[64] = {
    0x428a2f98u, 0x71374491u, 0xb5c0fbcfu, 0xe9b5dba5u, 0x3956c25bu, 0x59f111f1u, 0x923f82a4u, 0xab1c5ed5u,
    0xd807aa98u, 0x12835b01u, 0x243185beu, 0x550c7dc3u, 0x72be5d74u, 0x80deb1feu, 0x9bdc06a7u, 0xc19bf174u,
    0xe49b69c1u, 0xefbe4786u, 0x0fc19dc6u, 0x240ca1ccu, 0x2de92c6fu, 0x4a7484aau, 0x5cb0a9dcu, 0x76f988dau,
    0x983e5152u, 0xa831c66du, 0xb00327c8u, 0xbf597fc7u, 0xc6e00bf3u, 0xd5a79147u, 0x06ca6351u, 0x14292967u,
    0x27b70a85u, 0x2e1b2138u, 0x4d2c6dfcu, 0x53380d13u, 0x650a7354u, 0x766a0abbu, 0x81c2c92eu, 0x92722c85u,
    0xa2bfe8a1u, 0xa81a664bu, 0xc24b8b70u, 0xc76c51a3u, 0xd192e819u, 0xd6990624u, 0xf40e3585u, 0x106aa070u,
    0x19a4c116u, 0x1e376c08u, 0x2748774cu, 0x34b0bcb5u, 0x391c0cb3u, 0x4ed8aa4au, 0x5b9cca4fu, 0x682e6ff3u,
    0x748f82eeu, 0x78a5636fu, 0x84c87814u, 0x8cc70208u, 0x90befffau, 0xa4506cebu, 0xbef9a3f7u, 0xc67178f2u,
};

#define ROR(x, n) (((x) >> (n)) | ((x) << (32 - (n))))

static void block(n2_sha256_t *c, const uint8_t *p)
{
    uint32_t w[64];
    for (int i = 0; i < 16; i++) {
        w[i] = ((uint32_t)p[4 * i] << 24) | ((uint32_t)p[4 * i + 1] << 16) |
               ((uint32_t)p[4 * i + 2] << 8) | (uint32_t)p[4 * i + 3];
    }
    for (int i = 16; i < 64; i++) {
        uint32_t s0 = ROR(w[i - 15], 7) ^ ROR(w[i - 15], 18) ^ (w[i - 15] >> 3);
        uint32_t s1 = ROR(w[i - 2], 17) ^ ROR(w[i - 2], 19) ^ (w[i - 2] >> 10);
        w[i] = w[i - 16] + s0 + w[i - 7] + s1;
    }
    uint32_t a = c->h[0], b = c->h[1], cc = c->h[2], d = c->h[3];
    uint32_t e = c->h[4], f = c->h[5], g = c->h[6], h = c->h[7];
    for (int i = 0; i < 64; i++) {
        uint32_t S1 = ROR(e, 6) ^ ROR(e, 11) ^ ROR(e, 25);
        uint32_t ch = (e & f) ^ (~e & g);
        uint32_t t1 = h + S1 + ch + K[i] + w[i];
        uint32_t S0 = ROR(a, 2) ^ ROR(a, 13) ^ ROR(a, 22);
        uint32_t mj = (a & b) ^ (a & cc) ^ (b & cc);
        uint32_t t2 = S0 + mj;
        h = g;
        g = f;
        f = e;
        e = d + t1;
        d = cc;
        cc = b;
        b = a;
        a = t1 + t2;
    }
    c->h[0] += a;
    c->h[1] += b;
    c->h[2] += cc;
    c->h[3] += d;
    c->h[4] += e;
    c->h[5] += f;
    c->h[6] += g;
    c->h[7] += h;
}

void n2_sha256_init(n2_sha256_t *c)
{
    static const uint32_t iv[8] = { 0x6a09e667u, 0xbb67ae85u, 0x3c6ef372u, 0xa54ff53au,
                                    0x510e527fu, 0x9b05688cu, 0x1f83d9abu, 0x5be0cd19u };
    memcpy(c->h, iv, sizeof(iv));
    c->len = 0;
    c->n = 0;
}

void n2_sha256_update(n2_sha256_t *c, const void *data, size_t len)
{
    const uint8_t *p = (const uint8_t *)data;
    c->len += len;
    while (len > 0) {
        size_t take = 64 - c->n;
        if (take > len) {
            take = len;
        }
        memcpy(c->buf + c->n, p, take);
        c->n += take;
        p += take;
        len -= take;
        if (c->n == 64) {
            block(c, c->buf);
            c->n = 0;
        }
    }
}

void n2_sha256_final(n2_sha256_t *c, uint8_t out[32])
{
    uint64_t bits = c->len * 8u;
    uint8_t pad = 0x80;
    n2_sha256_update(c, &pad, 1);
    uint8_t zero = 0;
    while (c->n != 56) {
        n2_sha256_update(c, &zero, 1);
    }
    uint8_t lenb[8];
    for (int i = 0; i < 8; i++) {
        lenb[i] = (uint8_t)(bits >> (56 - 8 * i));
    }
    n2_sha256_update(c, lenb, 8);
    for (int i = 0; i < 8; i++) {
        out[4 * i] = (uint8_t)(c->h[i] >> 24);
        out[4 * i + 1] = (uint8_t)(c->h[i] >> 16);
        out[4 * i + 2] = (uint8_t)(c->h[i] >> 8);
        out[4 * i + 3] = (uint8_t)c->h[i];
    }
}

void n2_sha256(const void *data, size_t len, uint8_t out[32])
{
    n2_sha256_t c;
    n2_sha256_init(&c);
    n2_sha256_update(&c, data, len);
    n2_sha256_final(&c, out);
}

void n2_hmac_init(n2_hmac_t *h, const uint8_t *key, size_t keylen)
{
    uint8_t k[64];
    memset(k, 0, sizeof(k));
    if (keylen > 64) {
        n2_sha256(key, keylen, k);
    } else if (keylen > 0) {
        memcpy(k, key, keylen);
    }
    uint8_t ikey[64];
    for (int i = 0; i < 64; i++) {
        ikey[i] = (uint8_t)(k[i] ^ 0x36u);
        h->okey[i] = (uint8_t)(k[i] ^ 0x5Cu);
    }
    n2_sha256_init(&h->inner);
    n2_sha256_update(&h->inner, ikey, 64);
    memset(k, 0, sizeof(k));
    memset(ikey, 0, sizeof(ikey));
}

void n2_hmac_update(n2_hmac_t *h, const void *data, size_t len)
{
    n2_sha256_update(&h->inner, data, len);
}

void n2_hmac_final(n2_hmac_t *h, uint8_t out[32])
{
    uint8_t ih[32];
    n2_sha256_final(&h->inner, ih);
    n2_sha256_t o;
    n2_sha256_init(&o);
    n2_sha256_update(&o, h->okey, 64);
    n2_sha256_update(&o, ih, 32);
    n2_sha256_final(&o, out);
    memset(h->okey, 0, sizeof(h->okey));
}

int n2_ct_equal(const uint8_t *a, const uint8_t *b, size_t len)
{
    uint8_t d = 0;
    for (size_t i = 0; i < len; i++) {
        d |= (uint8_t)(a[i] ^ b[i]);
    }
    return d == 0;
}
