essensys-hub/essensys-i2c-etoile-0v/firmware/components/n2_core/src/n2_crc.c

#include "n2_crc.h"

uint16_t n2_crc16_modbus(const uint8_t *data, size_t len)
{
    uint16_t crc = 0xFFFF;
    for (size_t i = 0; i < len; i++) {
        crc ^= data[i];
        for (int b = 0; b < 8; b++) {
            if (crc & 1u) {
                crc = (uint16_t)((crc >> 1) ^ 0xA001u);
            } else {
                crc = (uint16_t)(crc >> 1);
            }
        }
    }
    return crc;
}

uint32_t n2_crc32(uint32_t crc, const uint8_t *data, size_t len)
{
    crc = ~crc;
    for (size_t i = 0; i < len; i++) {
        crc ^= data[i];
        for (int b = 0; b < 8; b++) {
            crc = (crc >> 1) ^ (0xEDB88320u & (uint32_t)(-(int32_t)(crc & 1u)));
        }
    }
    return ~crc;
}
