essensys-hub/essensys-i2c-etoile-0v/firmware/main/n2_console.h

#pragma once

/* Console locale (USB-Serial-JTAG) : seules actions « locales » sans authentification
 * réseau, réservées à une personne ayant physiquement accès au module. */
void n2_console_start(void);
