essensys-hub/essensys-i2c-etoile-0v/(commit log)

2026-10-12 feat: carte N2 étoile 0 V (projet KiCad, exports, rapports)
    Carte passive en étoile BP/BA avec plan 0 V, cavalier, PTC et TVS par port,
    extraite de essensys-board-SC944D (tâche 4.1). ERC/DRC : 0 erreur.
    Feature: i2c-surge-protection-2026-10-007
    Refs essensys-hub/essensys-board-SC944D#1
2026-10-12 docs(openspec): change n2-esp32-spy-alarm-2026-10-008 et manifest (essensys-hub/essensys-feature-lifecycle#28)
    Feature: n2-esp32-spy-alarm-2026-10-008
2026-10-12 docs(openspec): numéros des sous-issues dans tasks.md (essensys-hub/essensys-feature-lifecycle#28)
    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
2026-10-12 feat(firmware): module ESP32-C3 espion I2C passif, surveillance, alarme et surtensions (essensys-hub/essensys-feature-lifecycle#28)
    Projet ESP-IDF (cible esp32c3, ESP-IDF v5.3.2 figé en CI) :
    - profils dev (OTA signée vérifiée) et release (Secure Boot V2, chiffrement
    flash en mode Release, NVS chiffrée, anti-retour arrière) ;
    - logique pure dans components/n2_core, testée sur hôte (ctest, ASan/UBSan) :
    décodeur I2C passif sur traces SDA/SCL, trames BP<->BA (CRC-16/MODBUS,
    écho), journal horodaté et compteurs de pertes, BA muet, ligne collée,
    +15 V/PTC, alarme à boucles équilibrées, sirène bornée, latch surtension et
    écart de 0 V, journal non volatil avec reprise,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
2026-10-12 fix(firmware): déclaration de struct timeval pour le rappel NTP (essensys-hub/essensys-feature-lifecycle#28)
    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
2026-10-12 feat(n2): module ESP32 espion/alarme, schéma et PCB routé rév. B (essensys-hub/essensys-feature-lifecycle#28)
    - Schéma : ESP32-C3-MINI-1, isolateur ISO7720 2/0 (bus -> module seulement), 1 kΩ série,
    cavalier JP4, LDO LP2950 côté bus, RTC RV-3028 + supercondensateur, TCA9534.
    - Mesures : +15 V amont/aval des PTC (÷16), écart de 0 V (TLV9064, G = 0,249),
    4 x MCP3428, latch surtension (2 x LM339 + 74HC74, réarmement GPIO7).
    - Alimentation : PTC propre, SS14, SMAJ16A, AP63205 15->5 V, AP2112 3,3 V,
    chargeur LiFePO4 CN3058E 3,6 V 200 mA avec CTN, power-path SS14/AO3401A, 18650.
    - Alarme : 4 boucles équilibrées protégées, clé ARM, sirène 12 V (MT3608 + BTS4140N).
    - PCB 235 x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
2026-10-12 docs(openspec): tâches 1.1-1.3, 3.1, 3.2, 3.4, 5.3 et 9.1 cochées (essensys-hub/essensys-feature-lifecycle#28)
    ERC/DRC à 0 (b443f76), CI firmware verte (host + ESP-IDF dev/release),
    tests hôtes du décodeur sur traces, du mode debug et du rejet des
    commandes non authentifiées, README sans donnée privée.
    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
